MohamedAmr1312/XY-plotter/XY Gantry SYSTEM_V2.0.pdf

Mostafa Khaled

Omar Emad

Mariam Wael

Sama Atef

Hannah Reda

Mohamed Amr Mohamed

Ibrahim Ezzt

Adham Amr

Prepared by:

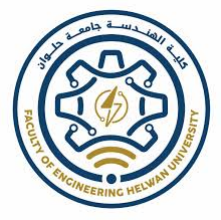
[picture p24: figure]

# XY Gantry SYSTEM

## MECHATRONICS SYSTEM DESIGN

2024/2025

Supervision:

Dr.Abdelhalim bassiouny

Project’s Aim:
This project aims to create a computer numerically controlled (CNC) plotter designed to produce accurate drawings based on 2D CAD files. The system translates CAD designs into digital coordinate commands, which are executed by the end-effector (pen) through a mechanism powered by stepper motors and timing belts, ensuring accurate replicate of the 2D designs.

Working Principle:
The xy gantry system depends on a single timing belt that is connected in a continous loop and mounted on two stepper motors to control the X-axis movement and the Y-axis movement based on the direction of rotation of the stepper motors, if the motors rotate in the same direction the gantry will move along X-axis, if the motors rotate in the opposite direction the gantry will move along the Y-axis.

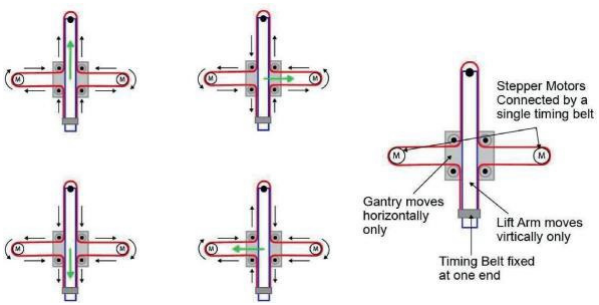
[picture p25: figure]
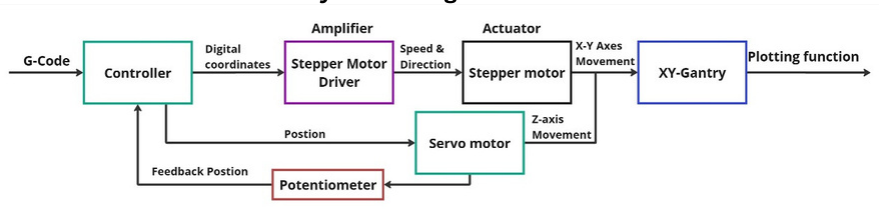
[picture p26: figure]

Mechatronics XY-Gantry Block Diagram:

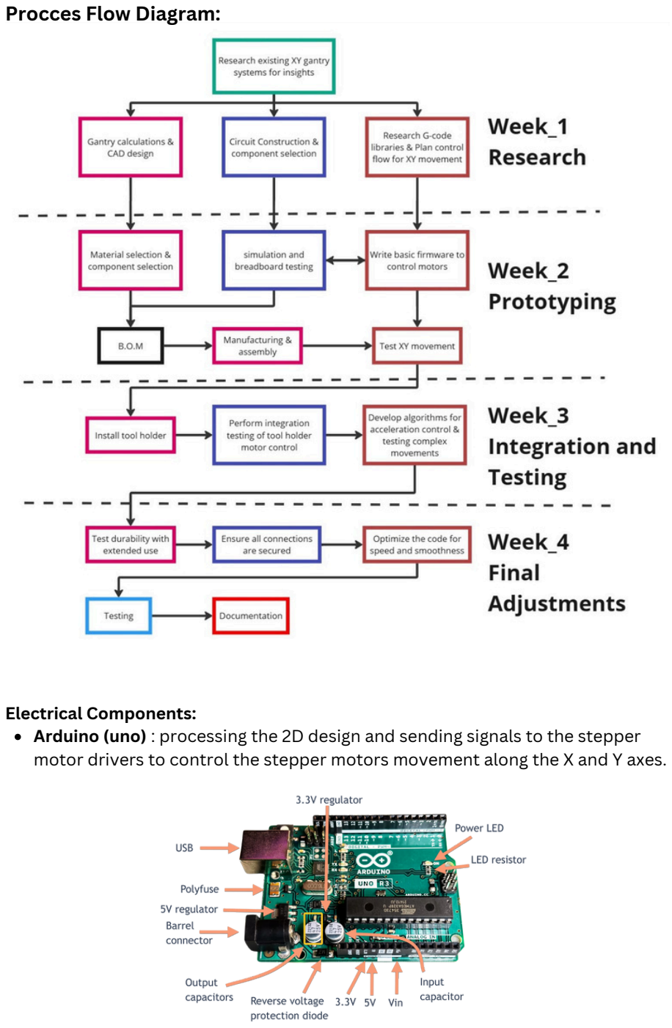
[picture p27: page 3]

Electrical Components:
Arduino (uno) : processing the 2D design and sending signals to the stepper motor drivers to control the stepper motors movement along the X and Y axes.

Procces Flow Diagram:

DRV8825 stepper motor driver: convert pulse signals from the controller into motor motion to achieve precise positioning
Nema 17 stepper motor: actuate the XY- gantry through rotational motion Servo motor (SG90): Responsible for the end-effector movement in the Z-axis Limit switches: Define limits in order to prevent a CNC from damaging itself if it travels past its limits
CNC expansion shield: simplify and facilitate the connection of stepper motors, drivers, and control signals to a microcontroller
Power supply: provide sufficent power for the system

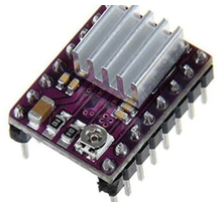
[picture p28: figure]
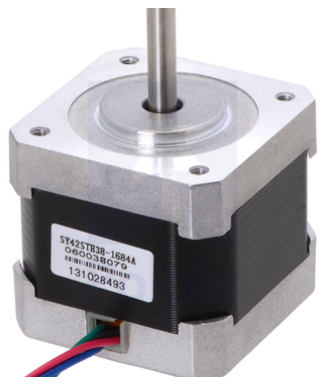
[picture p29: figure]
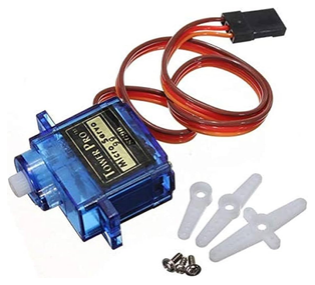
[picture p30: figure]

DRV8825 | Nema17 Stepper motor | SG90 Servo Motor

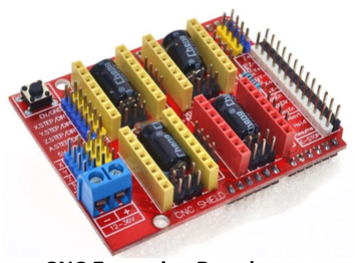
[picture p31: figure]
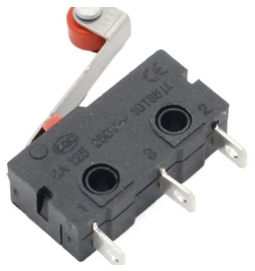
[picture p32: figure]

Limit Switches | CNC Expansion Board

Circuit Diagram:

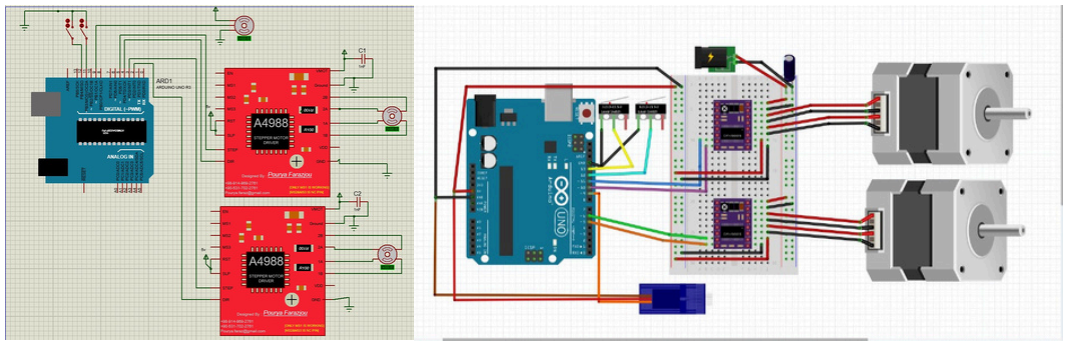
[picture p33: figure]

Power Transsmision elements:

The difference between the belt and lead screw for linear motion and which one of them is suitable for XY Gantry.

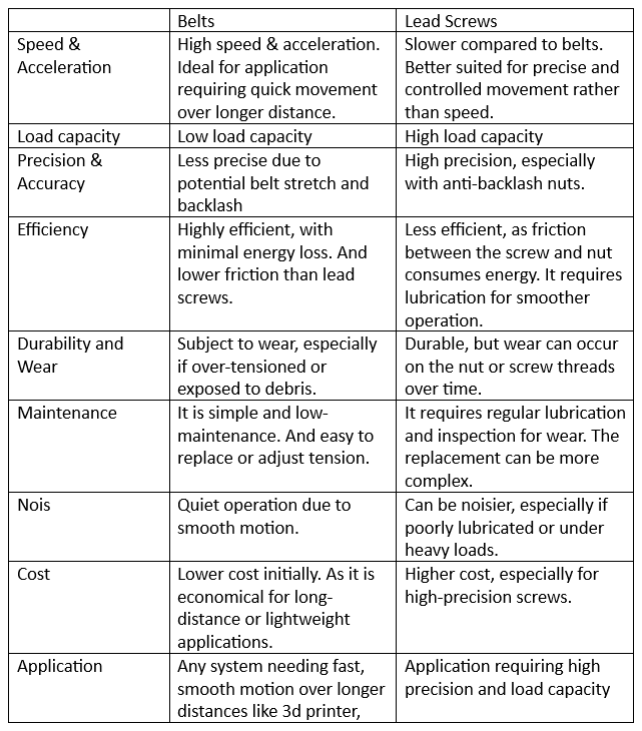
[picture p34: figure]

According to this comparison, the belt is suitable mechanism for XY Gantry applications.

Advantages of Timing Belts for XY Plotters:
High Precision: The toothed design ensures there is no slippage between the belt and pulley, allowing for precise motion, which is critical in applications like plotting, cutting, or 3D printing.
Smooth Motion: The continuous engagement of teeth with pulleys results in smooth and consistent movement, which is essential for maintaining drawing or cutting quality.
High-Speed Capability: Timing belts are lightweight and can move quickly, making them suitable for rapid positioning without losing accuracy.
Durability: Made from materials like polyurethane or reinforced rubber, they resist wear and provide a long service life under normal operating conditions.
Silent Operation: Compared to other mechanisms like chains or gears, timing belts are quiet, an advantage in environments where noise reduction is desirable.

Mechanical Components:

Timing Belts: Feature teeth that mesh with pulleys to prevent slippage, ensuring precise positioning.
Pulleys: Fixed to the shafts of stepper motors or idler shafts
Shaft Rods: Provide a path for the base of the xy gantry to move along Linear Bearing: provide free motion in both directions along the shaft rods

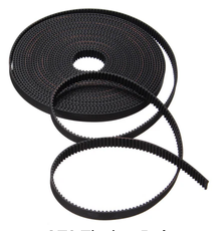
[picture p35: figure]

GT2 Timing Belt

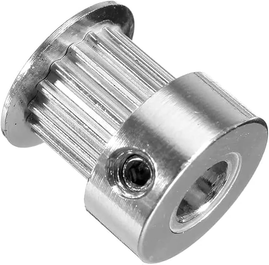
[picture p36: figure]

GT2 Pulley

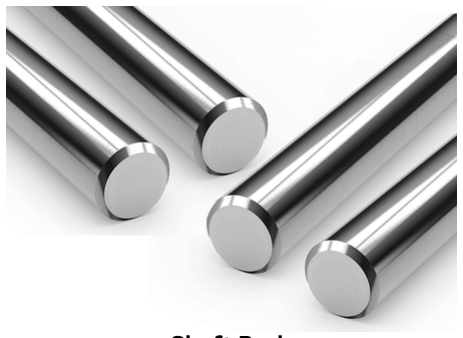
[picture p37: figure]
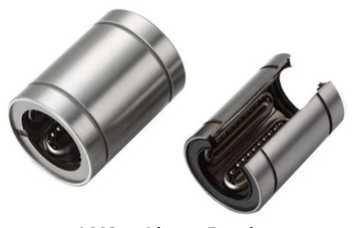
[picture p38: figure]

LM8uu Linear Bearing | Shaft Rods

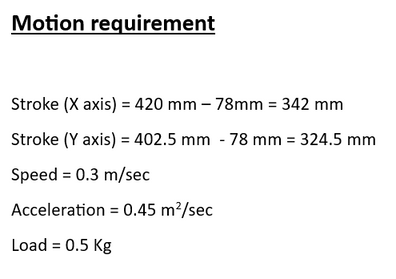
[picture p39: figure]

Belt Calculations

Belts that connect two pulleys together must have their specified tension to maintain the necessary friction between the belt and the pulleys to transmit torque successfully. We can use belts to link two pulleys of the same or different sizes, and we always do so on pulleys of the same surface.
Using longer belts than needed could result in the belts getting detached from the assembly. On the other hand, excessively forcing a short belt to fit a pulley system can lead to premature breakage of the belt. That is why we need to know precisely the correct belt length, just like getting the right gear sizes for a gear train.

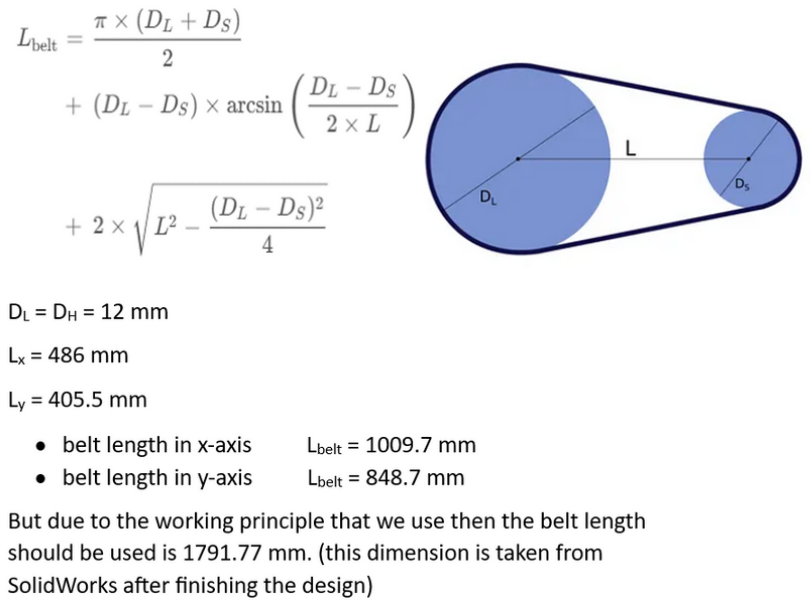
[picture p40: figure]
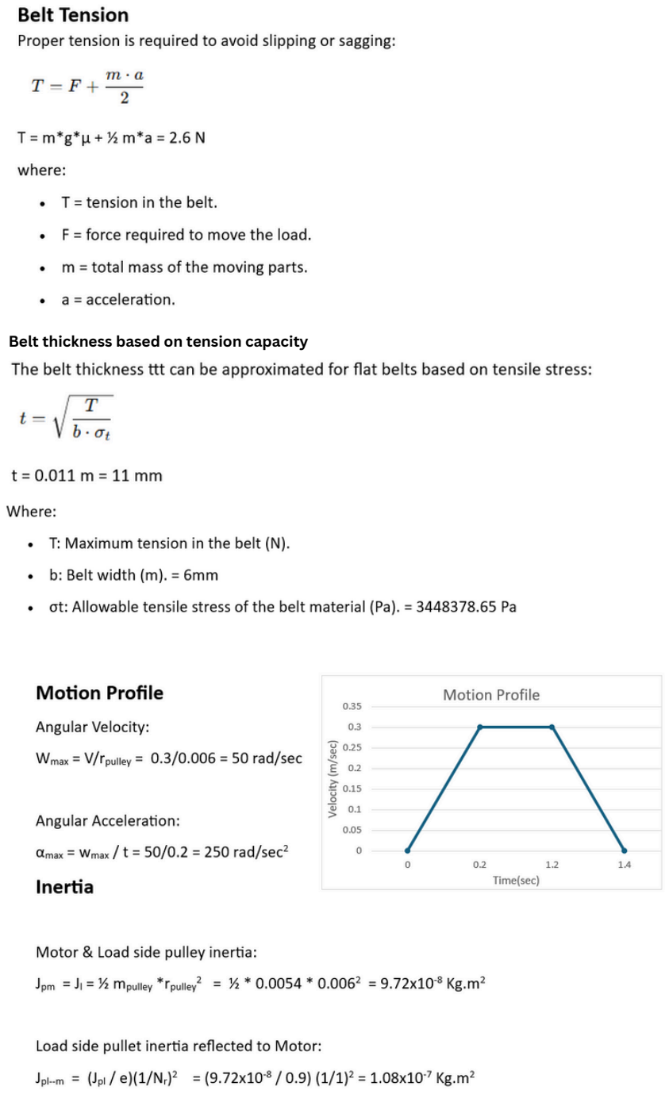
[picture p41: page 8]

Belt thickness based on tension capacity

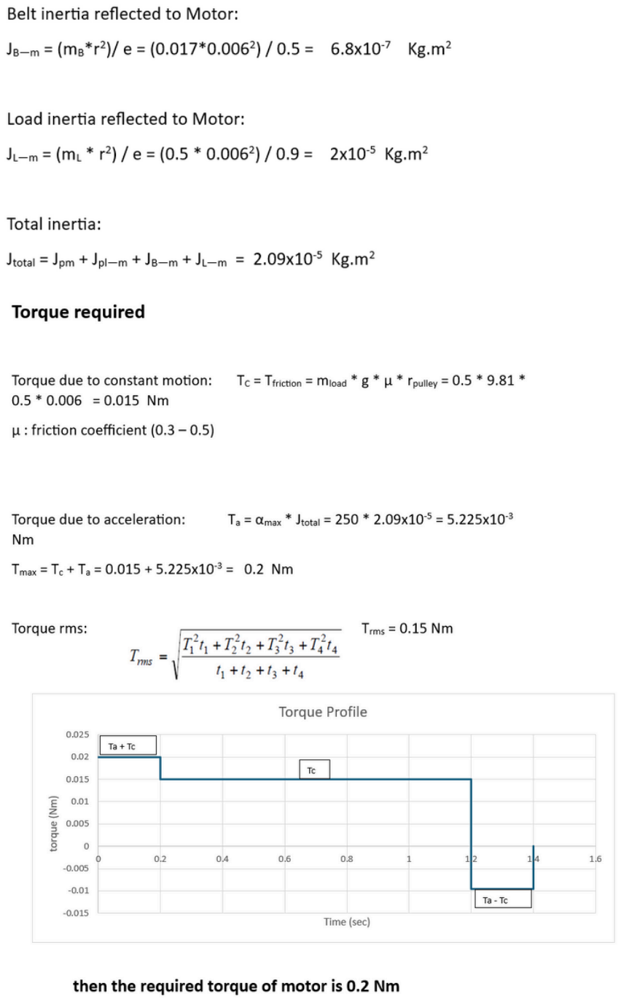
[picture p42: page 9]
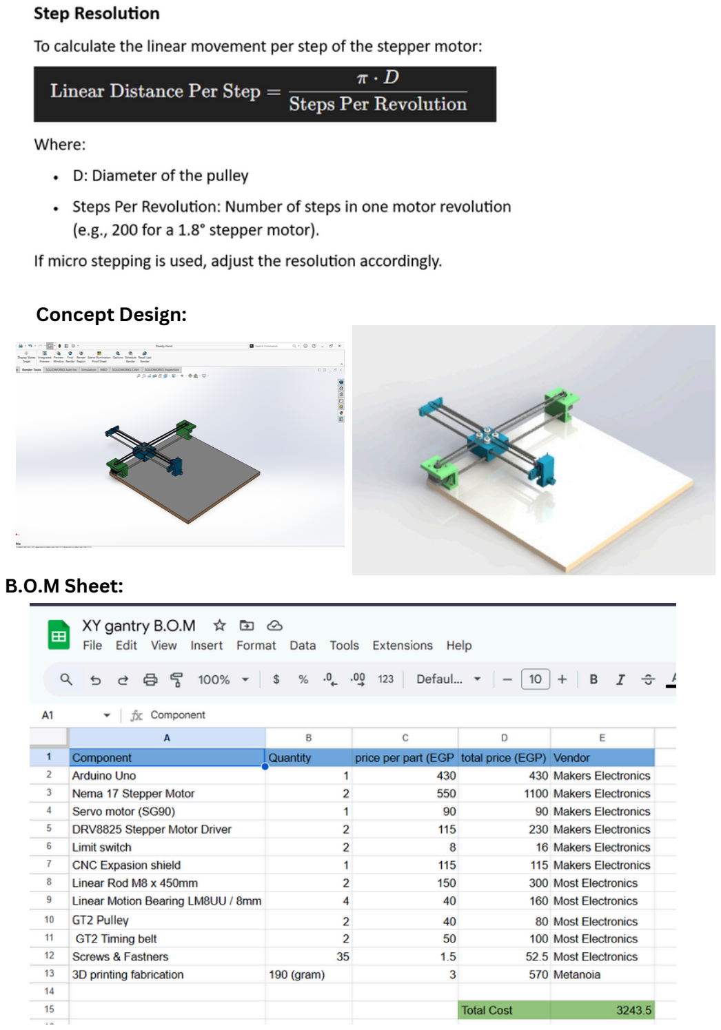
[picture p43: page 10]

Concept Design:

B.O.M Sheet:

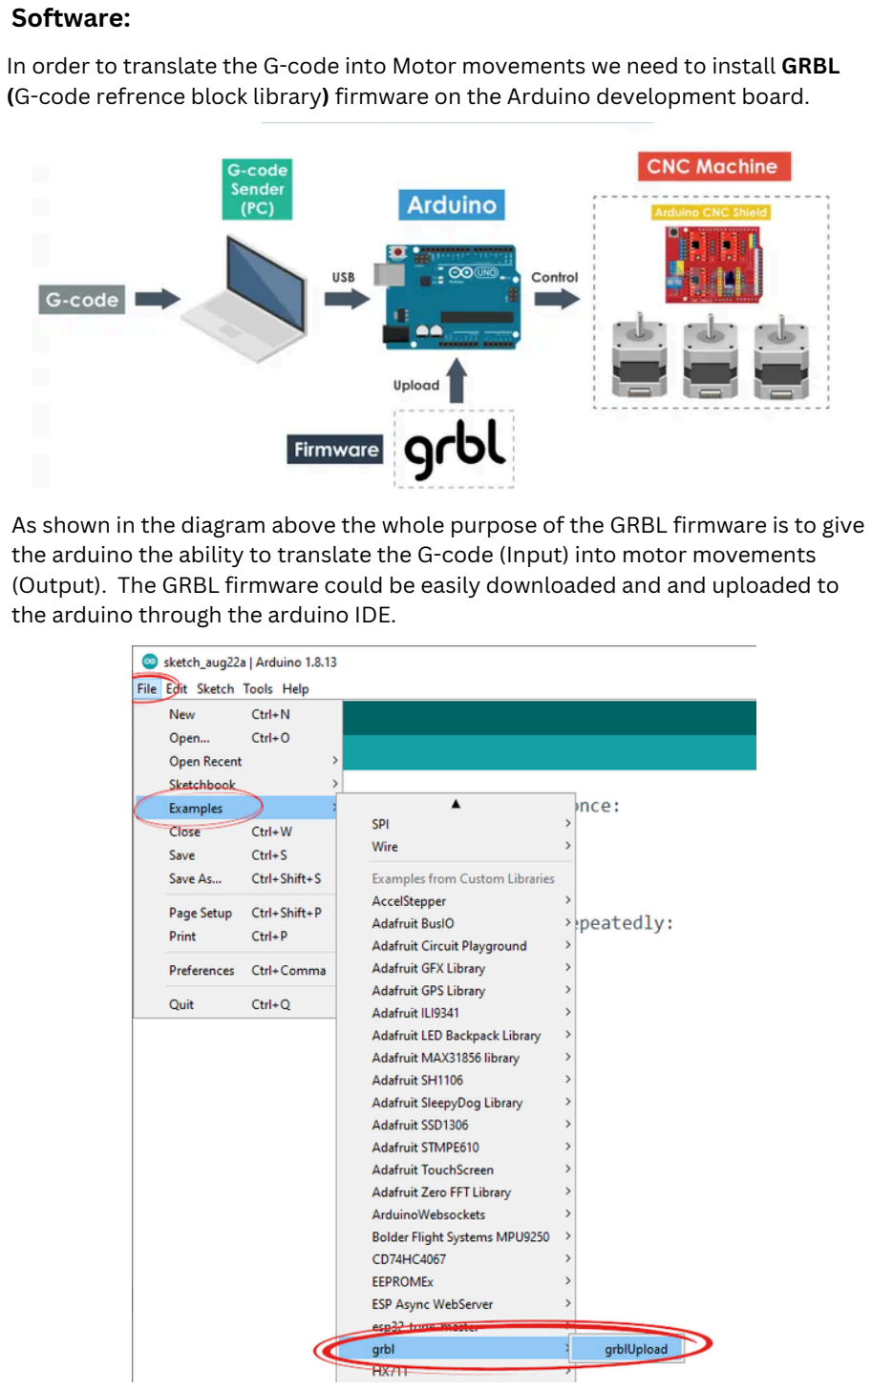
[picture p44: page 11]

Software:

In order to translate the G-code into Motor movements we need to install GRBL (G-code refrence block library) firmware on the Arduino development board.

As shown in the diagram above the whole purpose of the GRBL firmware is to give the arduino the ability to translate the G-code (Input) into motor movements (Output). The GRBL firmware could be easily downloaded and and uploaded to the arduino through the arduino IDE.

After giving the arduino the ability to translate G-code, a software is needed to send a g-code to the arduino in order to move the stepper motors accordingly. The software required is called UGS (Universal G-code sender) which is also considered as a GRBL controller

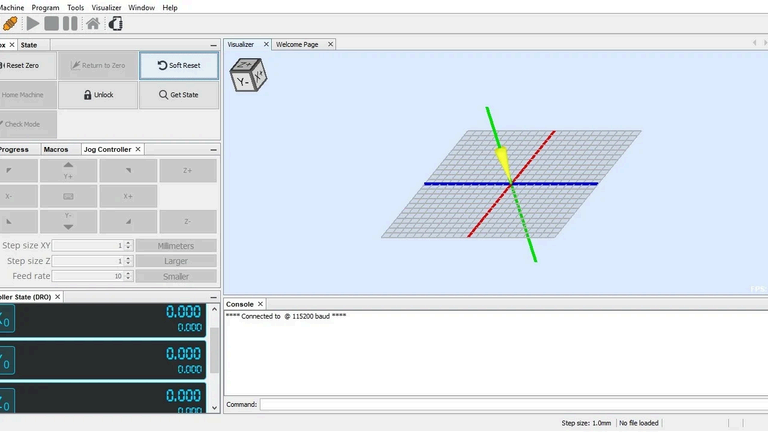
[picture p45: figure]

UGS software can aslo be used to configure the GRBL parameters, adjust the steps/mm parameter, configure the limit switch states and adjusting the autohome postion.
Now all what is needed is to generate a g-code to be passed on the UGS software in order to be translated into motor movements. The software used to generate g-code from 2D files is called Inkscape

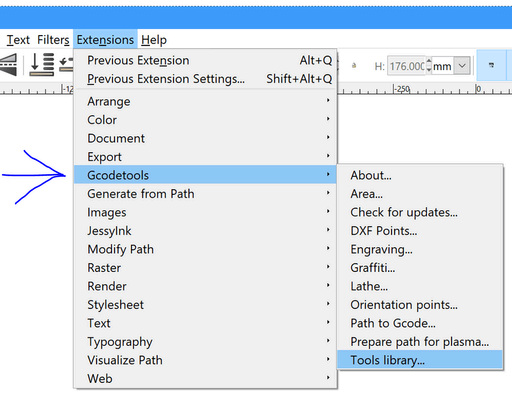
[picture p46: figure]
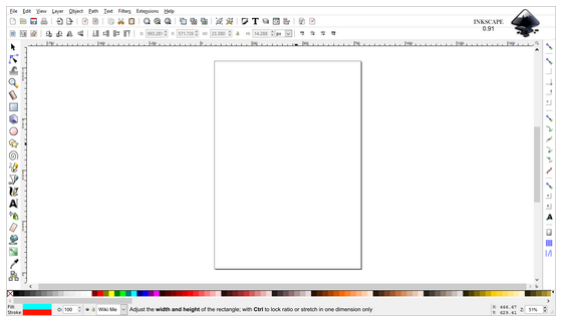
[picture p47: figure]
