MohamedAmr1312/XY-plotter/fully design/desgin/subAssem1.SLDASM

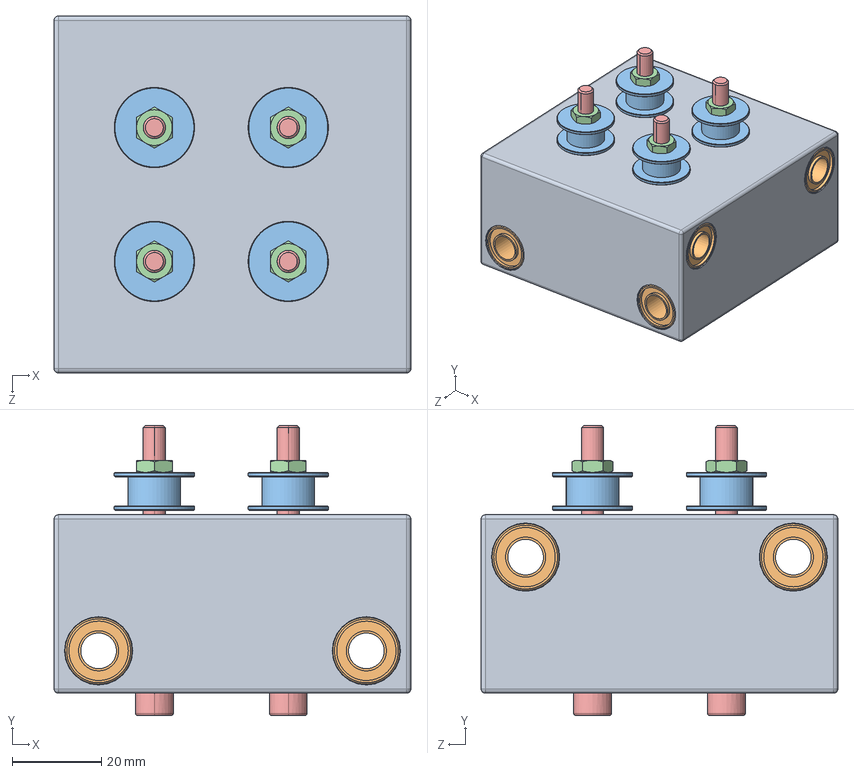
[picture p48: CAD file, 2025-05-02]
fully design/desgin/subAssem1.SLDASM
80.0 x 65.0 x 80.0 mm
Chariot
Roulement lineaire LM8UU x 8
Poulie lisse GT2 x 4
hex thin nut chamfered gradeab_iso x 4
VIS_CHC_M5x60 x 4
