MohamedAmr1312/XY-plotter/fully design/desgin/subAssem3.SLDASM

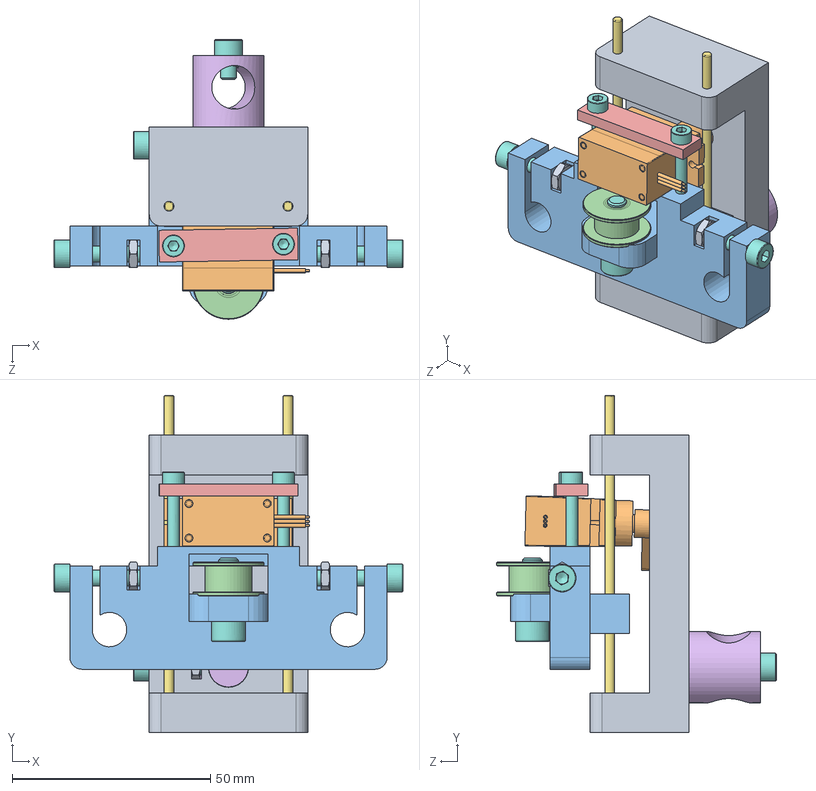
[picture p49: CAD file, 2025-05-02]
fully design/desgin/subAssem3.SLDASM
88.0 x 85.0 x 70.5 mm
Chariot stylo
Micro Servo SG90
Porte tiges Y avant
Poulie lisse GT2
support servo
Support stylo
Tige de guidage (chariot stylo) x 2
socket head cap screw_iso x 7
hex thin nut chamfered gradeab_iso x 3
