MohamedAmr1312/XY-plotter/fully design/desgin/subAssem2.SLDASM

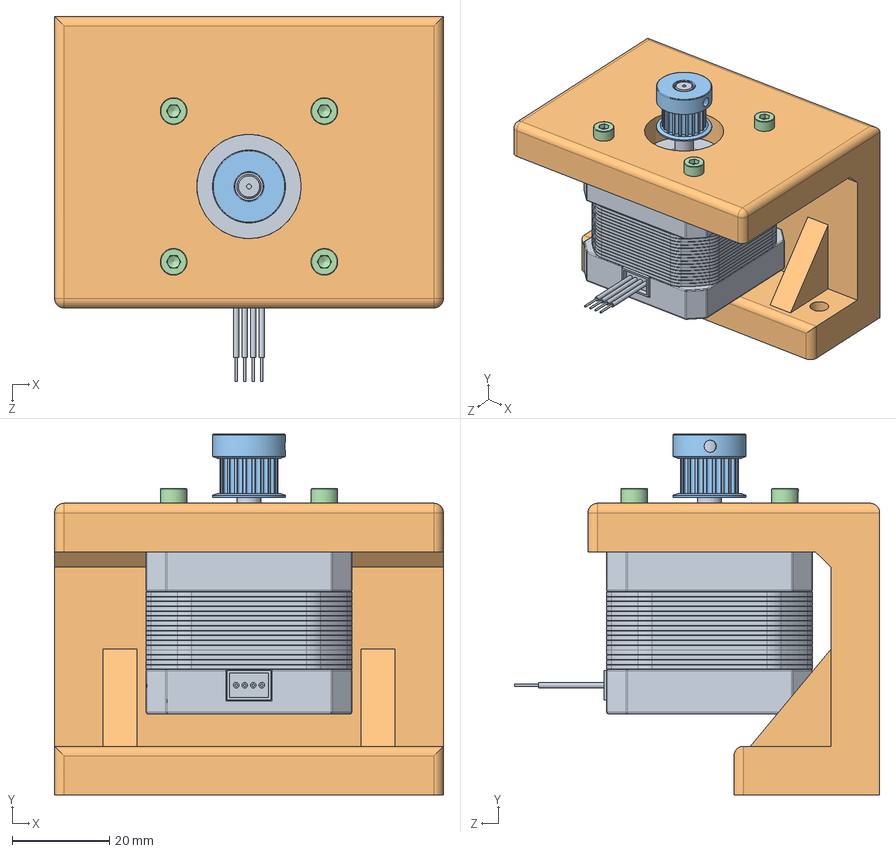
[picture p50: CAD file, 2025-05-02]
fully design/desgin/subAssem2.SLDASM
80.0 x 74.2 x 75.2 mm
Moteur pas a pas Nema 17
Porte tiges X
Poulie dentée GT2 20dents
socket head cap screw_iso x 4
