MohamedAmr1312/XY-plotter/fully design/n_gt2_firstpulley.SLDPRT

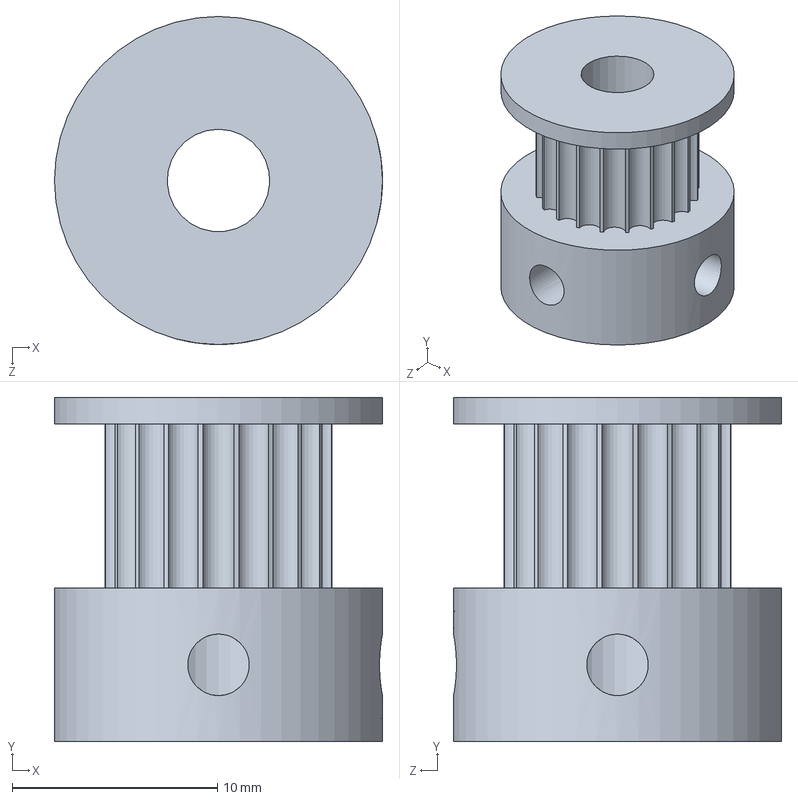
[picture p51: CAD file, 2025-05-02]
fully design/n_gt2_firstpulley.SLDPRT
16.0 x 16.8 x 16.0 mm
