MohamedAmr1312/XY-plotter/fully design/desgin/support servo.SLDPRT

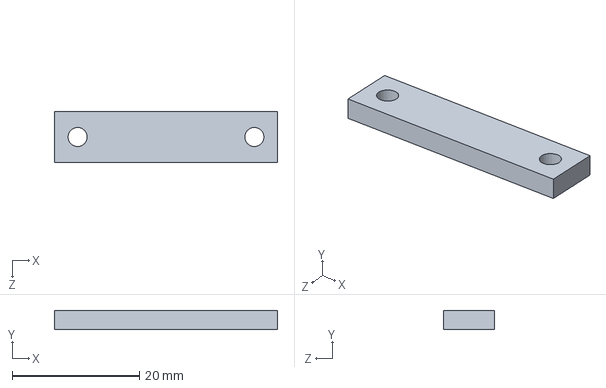
[picture p52: CAD file, 2025-05-02]
fully design/desgin/support servo.SLDPRT
35.0 x 3.00 x 8.00 mm
