MohamedAmr1312/XY-plotter/fully design/desgin/Porte tiges Y arriere.SLDPRT

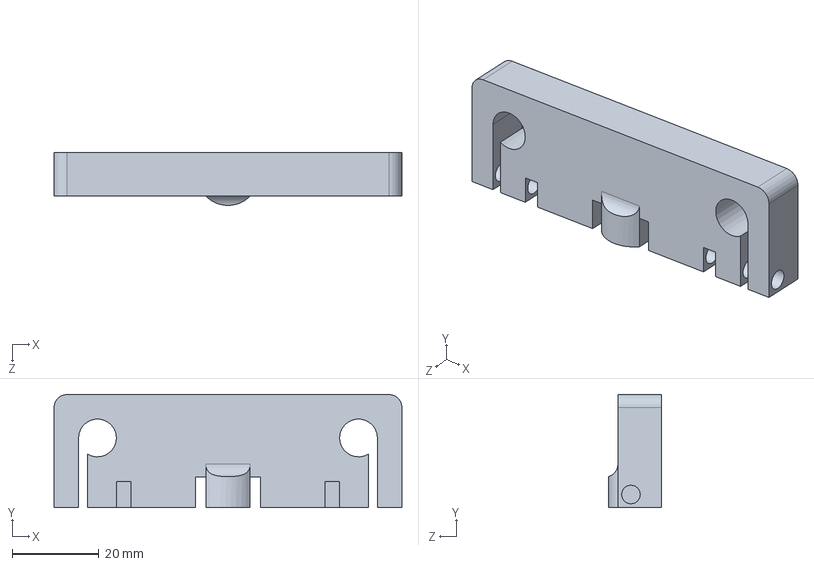
[picture p53: CAD file, 2025-05-02]
fully design/desgin/Porte tiges Y arriere.SLDPRT
80.0 x 26.0 x 12.1 mm
