MohamedAmr1312/XY-plotter/fully design/desgin/Poulie dentée GT2 20dents.SLDPRT

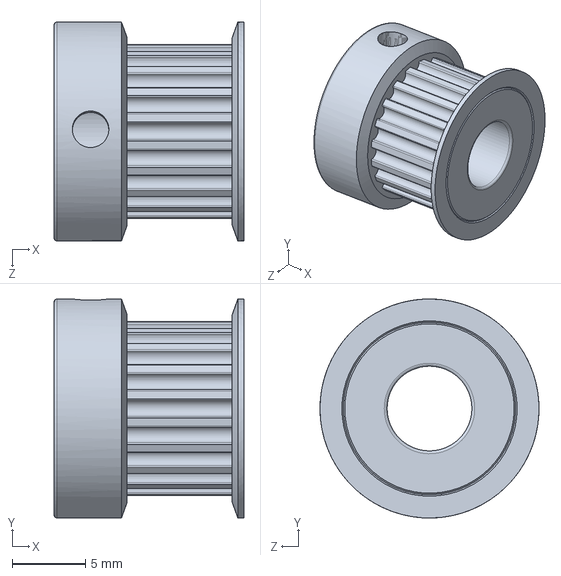
[picture p54: CAD file, 2025-05-02]
fully design/desgin/Poulie dentée GT2 20dents.SLDPRT
13.0 x 15.0 x 15.0 mm
