MohamedAmr1312/XY-plotter/fully design/desgin/Support stylo.SLDPRT

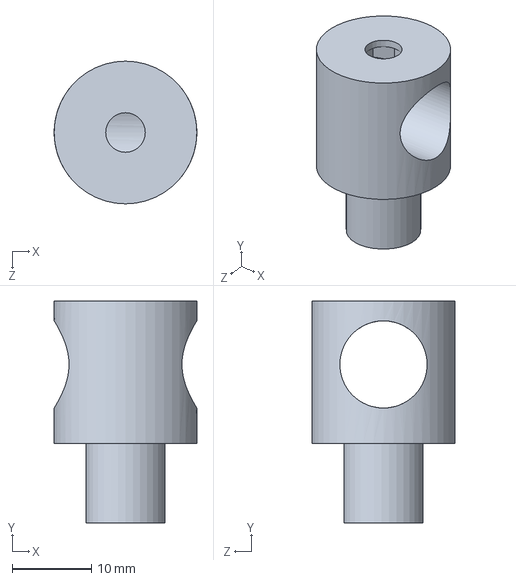
[picture p55: CAD file, 2025-05-02]
fully design/desgin/Support stylo.SLDPRT
18.0 x 28.0 x 18.0 mm
