MohamedAmr1312/XY-plotter/fully design/desgin/base.SLDPRT

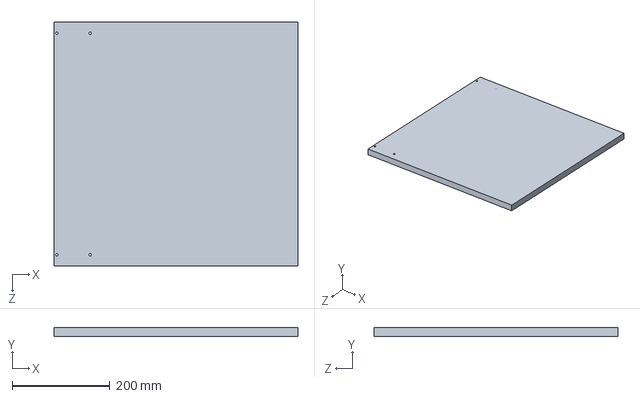
[picture p56: CAD file, 2025-05-02]
fully design/desgin/base.SLDPRT
500.0 x 18.0 x 500.0 mm
