MohamedAmr1312/XY-plotter/fully design/desgin/Courroie crantée GT2.sldprt

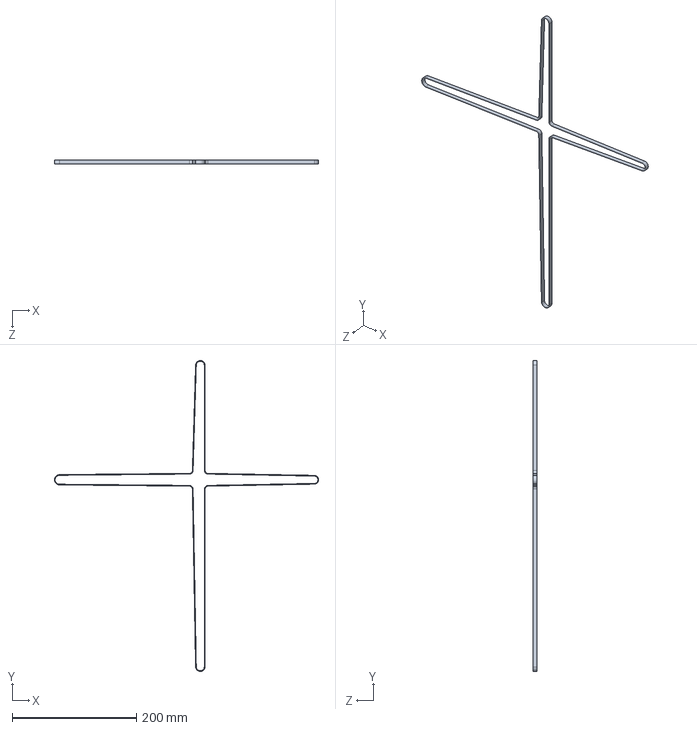
[picture p57: CAD file, 2025-05-02]
fully design/desgin/Courroie crantée GT2.sldprt
425.9 x 501.3 x 6.20 mm
