MohamedAmr1312/XY-plotter/fully design/desgin/Porte tiges X.SLDPRT

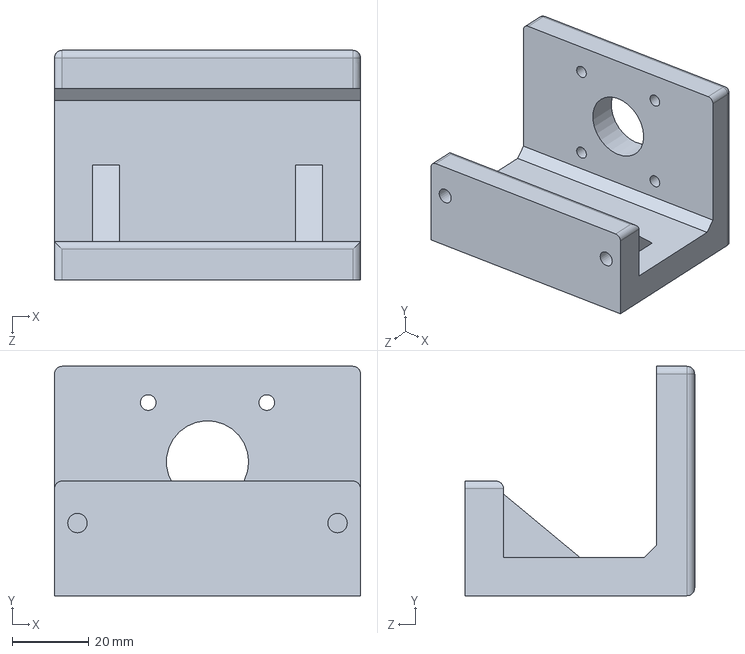
[picture p58: CAD file, 2025-05-02]
fully design/desgin/Porte tiges X.SLDPRT
80.0 x 60.0 x 60.0 mm
