MohamedAmr1312/XY-plotter/fully design/desgin/Moteur pas a pas Nema 17  .SLDPRT

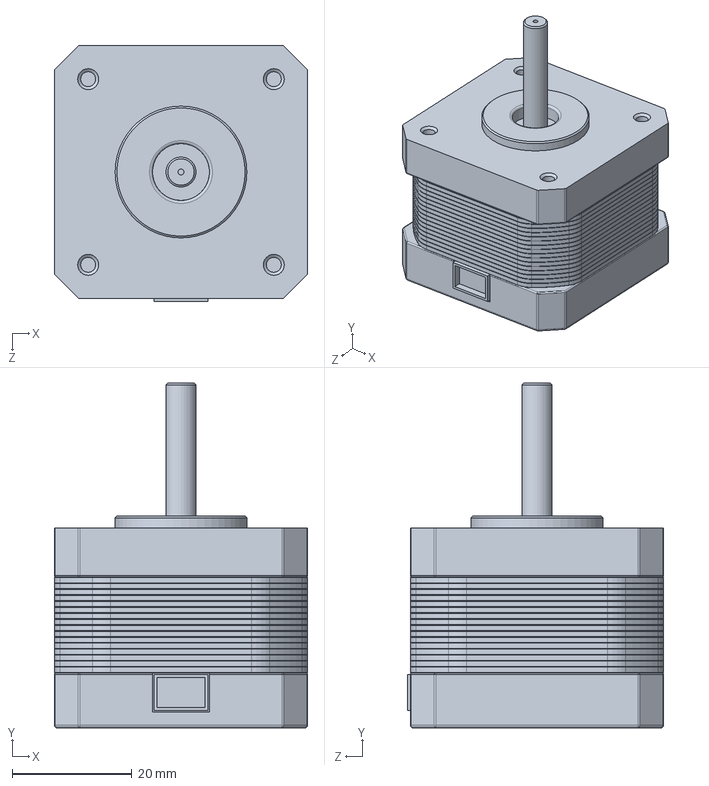
[picture p59: CAD file, 2025-05-02]
fully design/desgin/Moteur pas a pas Nema 17 .SLDPRT
42.3 x 57.6 x 42.8 mm
