MohamedAmr1312/XY-plotter/fully design/desgin/Chariot stylo.SLDPRT

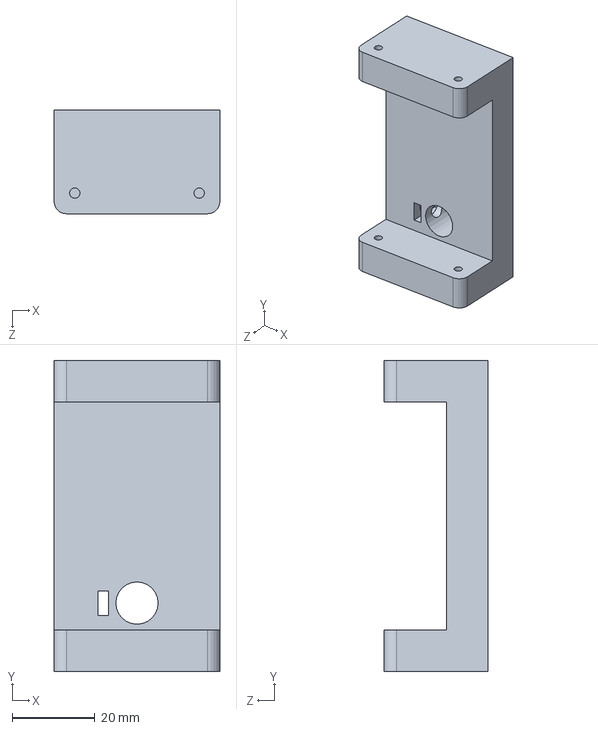
[picture p60: CAD file, 2025-05-02]
fully design/desgin/Chariot stylo.SLDPRT
40.0 x 75.0 x 25.0 mm
