MohamedAmr1312/XY-plotter/fully design/desgin/Chariot.SLDPRT

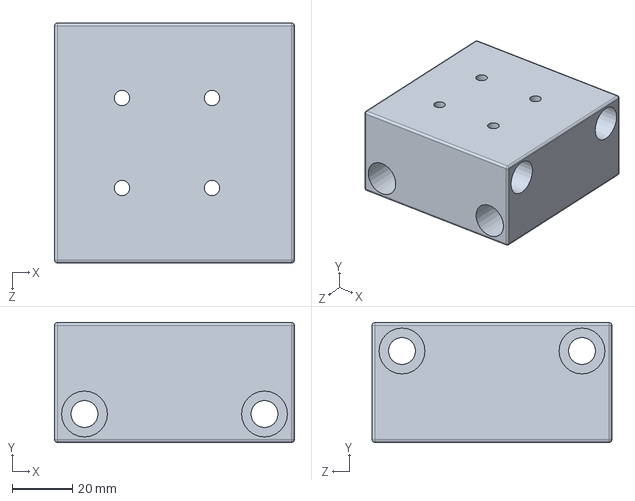
[picture p61: CAD file, 2025-05-02]
fully design/desgin/Chariot.SLDPRT
80.0 x 40.0 x 80.0 mm
