MohamedAmr1312/XY-plotter/fully design/desgin/Micro Servo SG90.SLDPRT

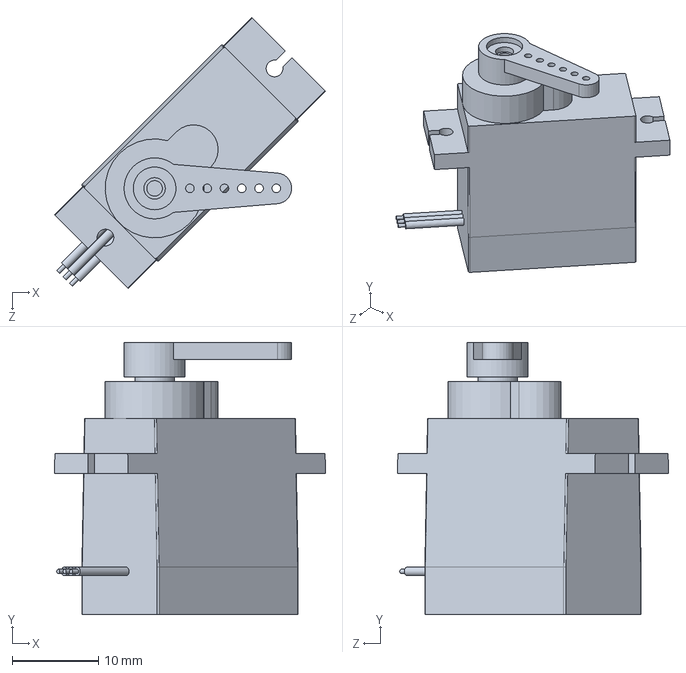
[picture p62: CAD file, 2025-05-02]
fully design/desgin/Micro Servo SG90.SLDPRT
31.4 x 31.5 x 31.4 mm
