MohamedAmr1312/XY-plotter/fully design/desgin/Poulie lisse GT2  .SLDPRT

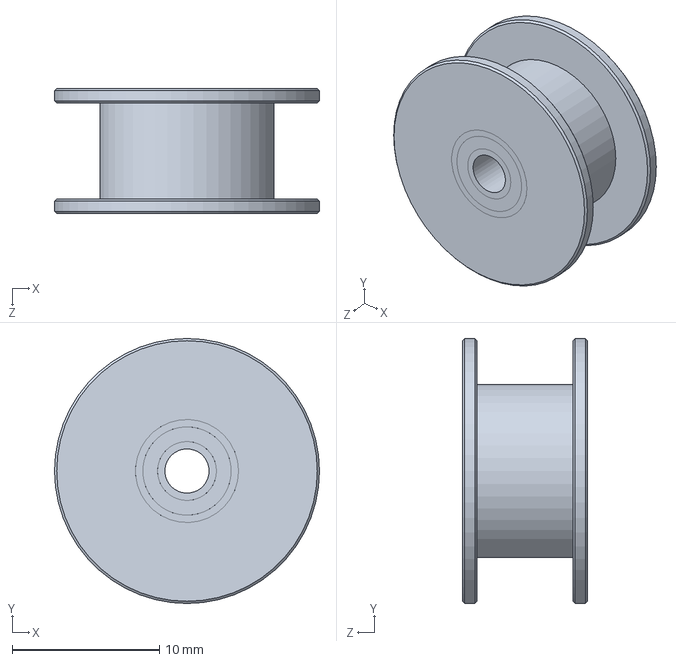
[picture p63: CAD file, 2025-05-02]
fully design/desgin/Poulie lisse GT2 .SLDPRT
18.0 x 18.0 x 8.50 mm
