MohamedAmr1312/XY-plotter/fully design/desgin/Roulement lineaire LM8UU.SLDPRT

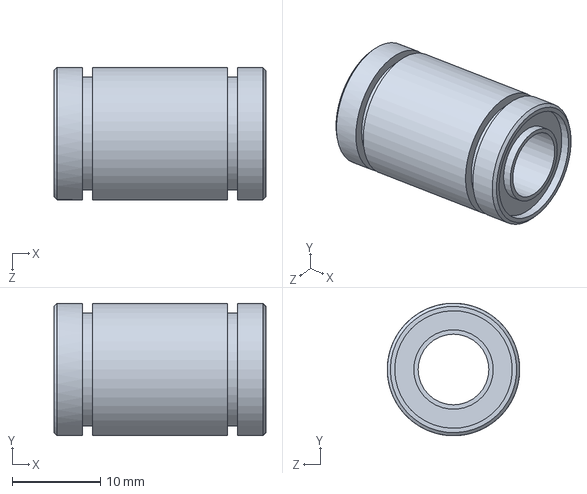
[picture p64: CAD file, 2025-05-02]
fully design/desgin/Roulement lineaire LM8UU.SLDPRT
24.0 x 15.0 x 15.0 mm
