MohamedAmr1312/XY-plotter/fully design/desgin/Porte tiges Y avant.SLDPRT

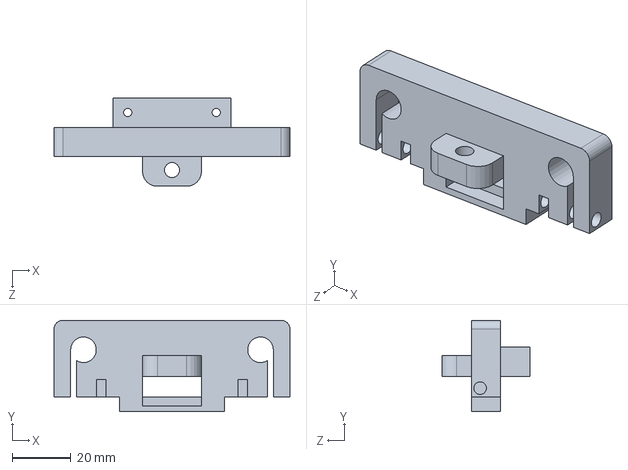
[picture p65: CAD file, 2025-05-02]
fully design/desgin/Porte tiges Y avant.SLDPRT
80.0 x 31.0 x 30.0 mm
