MohamedAmr1312/XY-plotter/fully design/desgin/Tige de guidage D8.SLDPRT

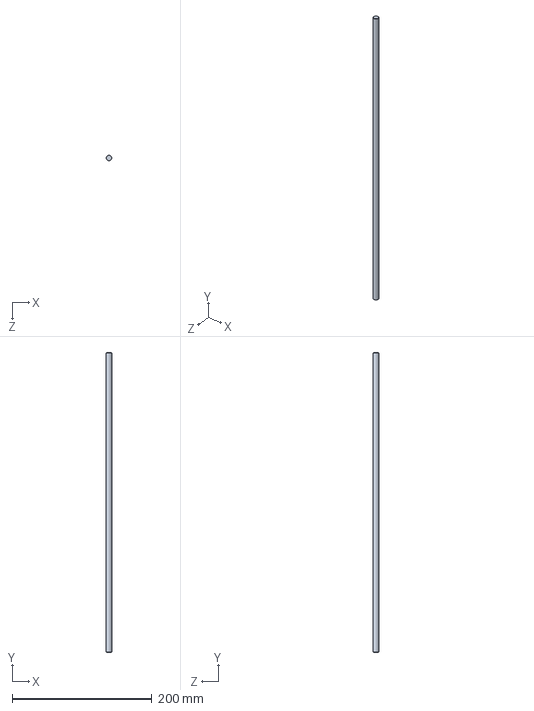
[picture p66: CAD file, 2025-05-02]
fully design/desgin/Tige de guidage D8.SLDPRT
8.00 x 430.0 x 8.00 mm
