MohamedAmr1312/XY-plotter/fully design/desgin/VIS_CHC_M5x60.SLDPRT

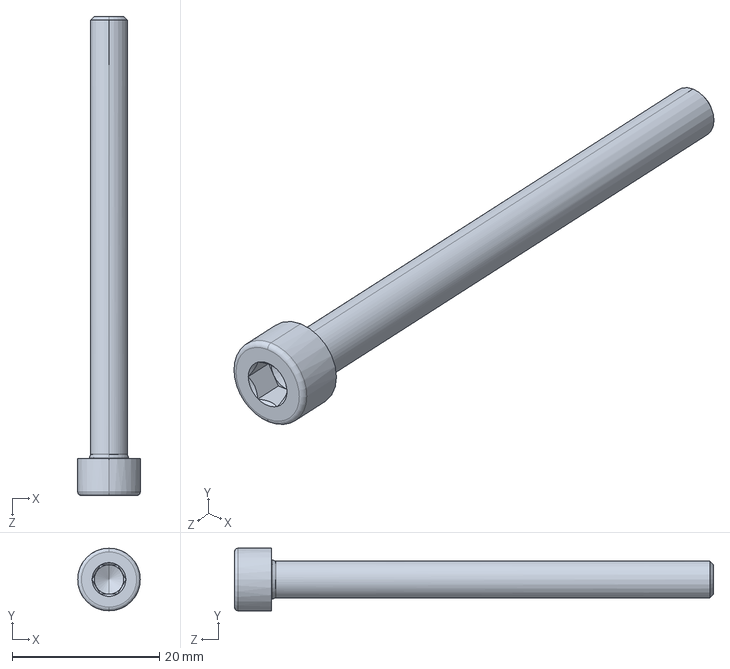
[picture p67: CAD file, 2025-05-02]
fully design/desgin/VIS_CHC_M5x60.SLDPRT
8.50 x 8.50 x 65.0 mm
