MohamedAmr1312/XY-plotter/fully design/desgin/Tige de guidage (chariot stylo) .SLDPRT

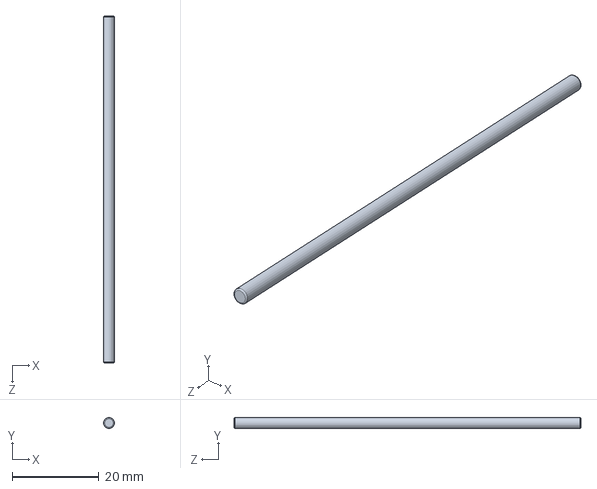
[picture p68: CAD file, 2025-05-02]
fully design/desgin/Tige de guidage (chariot stylo) .SLDPRT
2.50 x 2.50 x 80.0 mm
