MohamedAmr1312/XY-plotter/fully design/desgin/Steady-Hand.SLDASM

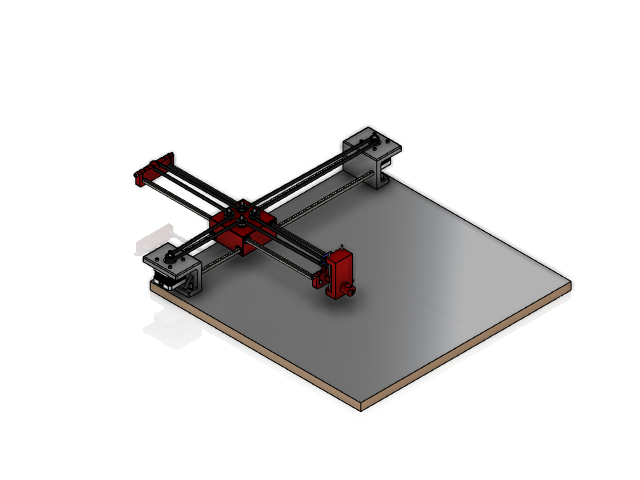
[picture p69: CAD file, 2025-05-02]
fully design/desgin/Steady-Hand.SLDASM
base
Porte tiges X x 2
Tige de guidage D8 x 4
Roulement lineaire LM8UU x 8
Chariot
Moteur pas a pas Nema 17 x 2
Porte tiges Y arriere
Poulie lisse GT2 x 5
Porte tiges Y avant
Tige de guidage (chariot stylo) x 2
Chariot stylo
Support stylo
Micro Servo SG90
Poulie dentée GT2 20dents x 2
socket head cap screw_iso x 16
hex thin nut chamfered gradeab_iso x 13
support servo
socket countersunk head screw_din x 4
Courroie crantée GT2
VIS_CHC_M5x60 x 4
